phamhuuhuyhoang/bench-pwr-rig/board/BOM/bom.xlsx

Sheet: Sheet1
PN | Qty | $ | Description |  | Des | Qty | $ | $
UCC25630-1DDBR (https://www.digikey.com/en/products/detail/texas-instruments/UCC25630-1DDBR/8106200) | 1 | 1.79 | hysteretic controller |  | C1 | 1 | 3.3 | 3.3 |  |  |  |  | Capacitor, | aluminum, | 47 | µF, | 450 | V, | ±20%, | 2.82 | ohm, | TH | B43501A5476M000 | TDK
IPAW60R180P7SXKSA1 (https://www.digikey.com/en/products/detail/infineon-technologies/IPAW60R180P7SXKSA1/6823347) | 2 | 1.55 | mosfet |  | C2 | 1 | 1.72 | 1.72 |  |  |  |  | Capacitor, | film, | 1.5uF, | 450V, | ±10%, | TH | ECQ-E2W155KH | Panasonic
 | 1 | 2.97 | Lresonant |  | C3, C4 | 2 | 0.98 | 1.96 |  |  |  |  | Capacitor, | film, | 1uF, | 275V, | ±20%, | TH | R46KN410000P0M | Kemet
 |  |  |  |  | C5 | 1 | 0.12 | 0.12 |  |  |  |  | Capacitor, | ceramic, | 220 | pF, | 50 | V, | ±10%, | X7R, | 603 | GRM188R71H221KA01D | MuRata
 |  |  |  |  | C6 | 1 | 0.83 | 0.83 |  |  |  |  | Capacitor, | film, | 0.47 | µF, | 630 | V, | ±10%, | TH | B32922C3474K | TDK
 |  |  |  |  | C7, C8 | 2 | 1.18 | 2.36 |  |  |  |  | Capacitor, | film, | 0.022 | µF, | 630 | V, | ±5%, | TH | ECWF6223JL | Panasonic
 |  |  |  |  | C9, C11 | 2 | 0.93 | 1.86 |  |  |  |  | Capacitor, | film, | 150 | pF, | 630 | V, | ±5%, | TH | PFR5151J630J11L4BULK | Kemet
 |  |  |  |  | C10 | 1 | 0.42 | 0.42 |  |  |  |  | Capacitor, | ceramic, | 0.015 | µF, | 25 | V, | ±5%, | C0G/NP0, | 603 | C0603C153J3GACTU | Kemet
 |  |  |  |  | C12 | 1 | 0.2 | 0.2 |  |  |  |  | Capacitor, | ceramic, | 2.2 | µF, | 35 | V, | ±10%, | X5R, | 603 | GRM188R6YA225KA12D | MuRata
 |  |  |  |  | C13 | 1 | 0.23 | 0.23 |  |  |  |  | Capacitor, | ceramic, | 3.9 | pF, | 50 | V, | ±6%, | C0G/NP0, | 603 | 06035A3R9CAT2A | AVX
 |  |  |  |  | C14, C15 | 2 | 0.34 | 0.68 |  |  |  |  | Capacitor, | ceramic, | 4.7 | µF, | 16 | V, | ±10%, | X5R, | 603 | GRM188R61C475KAAJ | MuRata
 |  |  |  |  | C16 | 1 | 0.69 | 0.69 |  |  |  |  | Capacitor, | aluminum, | 120 | µF, | 63 | V, | ± | 20%, | 0.194 | ohm, | AEC-Q200 | Grade | 2, | TH | EEU-FC1J121 | Panasonic
 |  |  |  |  | C17 | 1 | 0.31 | 0.31 |  |  |  |  | Capacitor, | ceramic, | 0.15 | µF, | 16 | V, | ±20%, | Y5V, | 603 | C0603C154Z4VACTU | Kemet
 |  |  |  |  | C18 | 1 | 0.36 | 0.36 |  |  |  |  | Capacitor, | ceramic, | 2.2 | µF, | 16 | V, | ±10%, | X7R, | 1206 | C1206C225K4RACTU | Kemet
 |  |  |  |  | C19 | 0 | 0.1 | 0 |  |  |  |  | Capacitor, | ceramic, | 10 | pF, | 50 | V, | ±5%, | C0G/NP0, | 603 | 06035A100JAT2A | AVX
 |  |  |  |  | C20, C21, C22, C23 | 4 | 0.54 | 2.16 |  |  |  |  | Capacitor, | aluminum, | 470 | µF, | 35 | V, | ±20%, | TH | 35ZL470MEFC10X20 | Rubycon
 |  |  |  |  | C24, C25, C26, C27 | 4 |  | 0 |  |  |  |  | Capacitor, | ceramic, | 22 | µF, | 35 | V, | ± | 20%, | X5R, | 805 | C2012X5R1V226M15AC | TDK
 |  |  |  |  | C28 | 1 | 0.12 | 0.12 |  |  |  |  | Capacitor, | ceramic, | 0.047 | µF, | 16 | V, | ±10%, | X7R, | 603 | GRM188R71C473KA01DMuRata
 |  |  |  |  | C29 | 0 |  | 0 |  |  |  |  | Capacitor, | ceramic, | 10 | pF, | 50 | V, | ±5%, | C0G/NP0, | 603 | 06035A100JAT2A | AVX
 |  |  |  |  | C30 | 0 |  | 0 |  |  |  |  | Capacitor, | ceramic, | 3300 | pF, | 50 | V, | ±5%, | C0G/NP0, | 603 | GRM1885C1H332JA01D | MuRata
 |  |  |  |  | D1, D2 | 2 | 0.42 | 0.84 |  |  |  |  | Diode, | Ultrafast, | 600 | V, | 1 | A, | SMA | MURA160T3G | ON | Semiconductor
 |  |  |  |  | D3 | 1 | 0.91 | 0.91 |  |  |  |  | Diode, | Switching-Bridge, | 420 | V, | 8 | A, | TH | GBU8J-BP | Micro | Commercial | Components
 |  |  |  |  | D4 | 1 | 1.02 | 1.02 |  |  |  |  | Diode, | Schottky, | 60 | V, | 1 | A, | AEC-Q101, | SMB | STPS160UY | STMicroelectronics
 |  |  |  |  | D5 | 1 | 0.35 | 0.35 |  |  |  |  | Diode, | Ultrafast, | 600 | V, | 1 | A, | AEC-Q101, | SMAF | ES1JAF | Fairchild | Semiconductor
 |  |  |  |  | D6, D7 | 2 |  | 0 |  |  |  |  | Diode, | Schottky, | 100 | V, | 20 | A, | AEC-Q101, | TH | STPS41H100CTY | STMicroelectronics
 |  |  |  | Q6,Q7 |  | 2 | 1.62 | 3.24 | IPP086N10N3GXKSA1 (https://www.digikey.com/en/products/detail/infineon-technologies/IPP086N10N3GXKSA1/2081155)
 |  |  |  |  | D8, D9 | 2 | 0.16 | 0.32 |  |  |  |  | Diode, | Ultrafast, | 100 | V, | 0.15 | A, | SOD-123 | 1N4148W-7-F | Diodes | Inc.
 |  |  |  |  | D10 | 1 | 0.2 | 0.2 |  |  |  |  | Diode, | Zener, | 6.2 | V, | 500 | mW, | SOD-123 | MMSZ5234B-7-F | Diodes | Inc.
 |  |  |  |  | H1, H3, H5, H7 | 4 |  | 0 |  |  |  |  | Hex | standoff | 1-1/2" | L | #6-32 | nylon | 4824 | Keystone
 |  |  |  |  | H2, H4, H6, H8 | 4 |  | 0 |  |  |  |  | Hex | standoff | 0.5"L | #6-32 | nylon | 1903C | Keystone
 |  |  |  |  | H9, H11 | 2 |  | 0 |  |  |  |  | TO-220 | mounting | kit | 4880SG | Aavid | Thermalloy
 |  |  |  |  | H10, H12 | 2 |  | 0 |  |  |  |  | TO-247 | mounting | kit | 4880SG | Aavid | Thermalloy
 |  |  |  |  | H13, H14 | 2 |  | 0 |  |  |  |  | Large | thermal | pad | to | substitute | for | the | smaller | one | in | the | TO-247 | Mounting | Kit | SP900S-0.009-00-104 | Bergquist
 |  |  |  |  | HS1, HS2, HS3, HS4 | 4 |  | 0 |  |  |  |  | Heatsink | TO-220 | w/pins | 1.5" | tall | 531102B02500G | Aavid
 |  |  |  |  | J1 | 1 |  | 0 |  |  |  |  | Terminal | block, | 5.08 | mm, | 3x1, | brass, | TH | ED120/3DS | On-Shore | Technology
 |  |  |  | Uxx |  | 1 | 1.95 | 1.95 | UCC24624
 |  |  |  |  | U1 | 1 | 1.79 | 1.79 | UCC25630-1DDBR (https://www.digikey.com/en/products/detail/texas-instruments/UCC25630-1DDBR/8106200) |  |  | Enhanced | LLC | Resonant | Controller | with | Driver, | DDB0014A | UCC256301DDB | Texas | Instruments
 |  |  |  |  | U2, U3 | 2 | 0.58 | 1.16 |  |  |  | Optocoupler, | 5.3 | kV, | 50-600% | CTR, | TH | VO618A-3 | Vishay-Semiconductor
 |  |  |  |  | U4 | 1 | 0.24 | 0.24 |  |  |  | Low-Voltage | Adjustable | Precision | Shunt | Regulator, | 80mA, | -40 | to | 125 | degC, | 3-pin | SOT-89 | (PK), | Green | (RoHS | & | no | Sb/Br) | TLVH431AQPK | Texas | Instruments
 |  |  |  |  | Q1, Q2 | 2 | 2.25 | 4.5 | FCP190N65S3
 |  |  |  |  | J2, J3 | 2 |  | 0 |  | Terminal | block, | 5.08 | mm, | 2x1, | brass, | TH | ED120/2DS | On-Shore | Technology
 |  |  |  |  | J4 | 1 |  | 0 |  | Header, | 100.00 | mil, | 2 | x | 1, | tin, | TH | PEC02SAAN | Sullins | Connector | Solutions
 |  |  |  |  | J5 | 1 |  | 0 |  | Terminal | block, | 5.08 | mm, | 4x1, | brass, | TH | ED120/4DS | On-Shore | Technology
 |  |  |  |  | L1 | 1 | 3 | 3 |  | Inductor, | 50.00 | µH, | 0.023 | Ω, | TH | RLTI-1234 | Renco | Electronics
 |  |  |  |  | R1, R2, R3 | 3 | 0.1 | 0.3 |  | Resistor, | 4.99 | MΩ, | 1%, | 0.25 | W, | 1206 | CRCW12064M99FKEA | Vishay-Dale
 |  |  |  |  | R4 | 1 | 0.1 | 0.1 |  | Resistor, | 140.00 | kΩ, | 1%, | 0.1 | W, | 603 | CRCW0603140KFKEA | Vishay-Dale
 |  |  |  |  | R5, R6 | 2 | 0.1 | 0.2 |  | Resistor, | 10 | Ω, | 1%, | 0.125 | W, | 805 | CRCW080510R0FKEA | Vishay-Dale
 |  |  |  |  | R7, R8 | 2 | 0.1 | 0.2 |  | Resistor, | 5.11 | kΩ, | 1%, | 0.1W, | 603 | CRCW06035K11FKEA | Vishay-Dale
 |  |  |  |  | R9, R10, R11 | 3 | 0.1 | 0.3 |  | Resistor, | 1.65 | kΩ, | 1%, | 0.25 | W, | 1206 | CRCW12061K65FKEA | Vishay-Dale
 |  |  |  |  | R12, R27, R28, R29 | 4 | 0.1 | 0.4 |  | Resistor, | 10 | MΩ, | 1%, | 0.25 | W, | 1206 | CRCW120610M0FKEA | Vishay-Dale
 |  |  |  |  | R13 | 1 | 0.1 | 0.1 |  | Resistor, | 357.00 | Ω, | 1%, | 0.25 | W, | 1206 | CRCW1206357RFKEA | Vishay-Dale
 |  |  |  |  | R14 | 1 | 0.1 | 0.1 |  | Resistor, | 732.00 | kΩ, | 1%, | 0.1 | W, | 603 | CRCW0603732KFKEA | Vishay-Dale
 |  |  |  |  | R15 | 1 | 0.1 | 0.1 |  | Resistor, | 402.00 | kΩ, | 1%, | 0.1 | W, | 603 | CRCW0603402KFKEA | Vishay-Dale
 |  |  |  |  | R16 | 1 | 0.1 | 0.1 |  | Resistor, | 2.20 | Ω, | 5%, | 0.1 | W, | 603 | CRCW06032R20JNEA | Vishay-Dale
 |  |  |  |  | R17 | 1 | 0.1 | 0.1 |  | Resistor, | 42.20 | kΩ, | 1%, | 0.1 | W, | 603 | CRCW060342K2FKEA | Vishay-Dale
 |  |  |  |  | R18, R21, R22 | 3 | 0.1 | 0.3 |  | Resistor, | 10 | kΩ, | 1%, | 0.1 | W, | 603 | CRCW060310K0FKEA | Vishay-Dale
 |  |  |  |  | R19 | 1 | 0.1 | 0.1 |  | Resistor, | 2.00 | kΩ, | 1%, | 0.1 | W, | 603 | CRCW06032K00FKEA | Vishay-Dale
 |  |  |  |  | R20, R23 | 2 | 0.1 | 0.2 |  | Resistor, | 6.04 | kΩ, | 1%, | 0.1 | W, | 603 | CRCW06036K04FKEA | Vishay-Dale
 |  |  |  |  | R24, R32 | 2 | 0.1 | 0.2 |  | Resistor, | 0 | Ω, | 5%, | 0.1 | W, | 603 | CRCW06030000Z0EA | Vishay-Dale
 |  |  |  |  | R25 | 1 | 0.1 | 0.1 |  | Resistor, | 147.00 | kΩ, | 1%, | 0.1 | W, | 603 | CRCW0603147KFKEA | Vishay-Dale
 |  |  |  |  | R26 | 1 | 0.1 | 0.1 |  | Resistor, | 16.90 | kΩ, | 1%, | 0.1 | W, | 603 | CRCW060316K9FKEA | Vishay-Dale
 |  |  |  |  | R30, R31 | 2 | 0.1 | 0.2 |  | Resistor, | 1 | Ω, | 1%, | 0.125 | W, | 805 | CRCW08051R00FKEA | Vishay-Dale
 |  |  |  |  | RV1 | 1 | 0.55 | 0.55 |  | Varistor | 558.00 | V | 4.5KA, | TH | MOV-14D621K | Bourns
 |  |  |  |  | T1 | 1 |  | 0 |  | Transformer, | 840.00 | µH, | TH | RLTI-1233 | Renco | Electronics
 |  |  |  |  |  |  |  | 40.59

Sheet: Magnetic
 | Qty | $
PQ26/20-3C95 | 1 | 2.83
CLM/P-PQ26/20 | 1 | 1.35
CPV-PQ26/20-1S-12PD-Z | 1 | 0.97
 |  | 5.15
