phamhuuhuyhoang/bench-pwr-rig/board/bench_pwr_rig/bench_pwr_rig.kicad_pcb

## KiCad design board/bench_pwr_rig/bench_pwr_rig.kicad_pcb (2020-11-18)

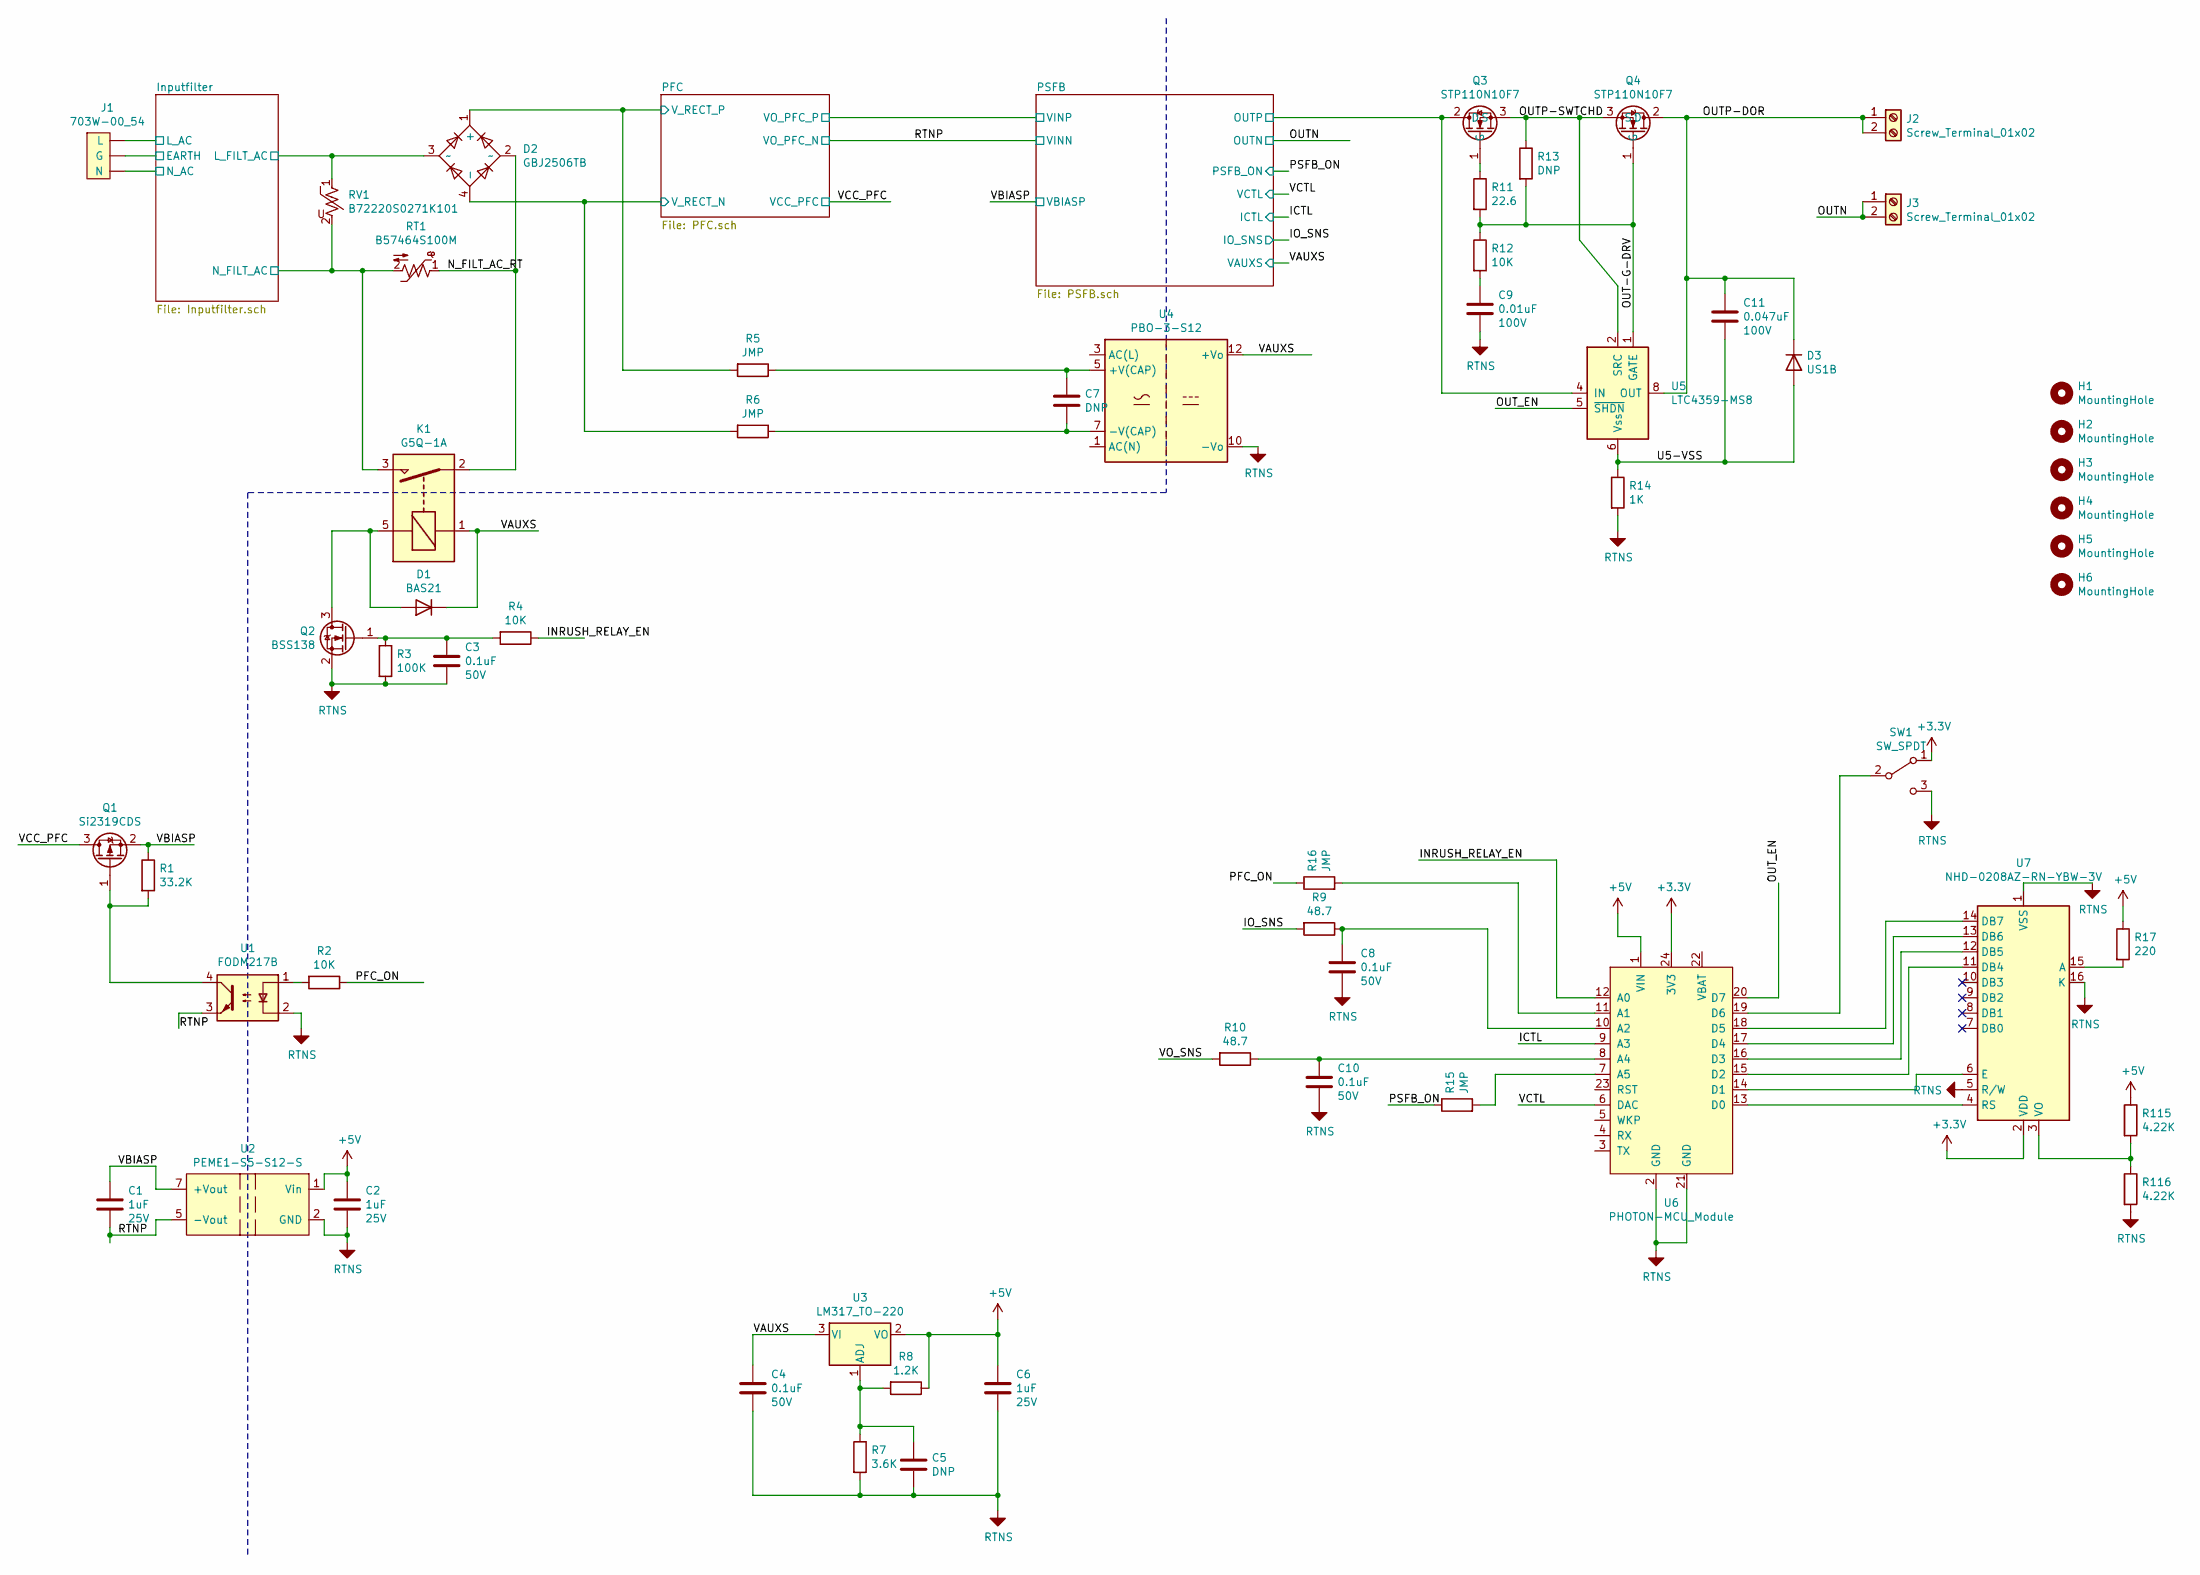
[picture p1: schematic bench_pwr_rig.sch, Bench Power Rig]

Parts:
C1, C2, C6: C1608X7R1E105K080AB; C_0603_1608Metric_Pad1.05x0.95mm_HandSolder; Voltage 25V
C3, C4, C8, C10: C1608X7R1H104K; C_0603_1608Metric_Pad1.05x0.95mm_HandSolder; Voltage 50V
C5: DNP; C_0603_1608Metric_Pad1.05x0.95mm_HandSolder
C7: DNP; C_1206_3216Metric
C9: CL21B103KCANNNC; C_0805_2012Metric_Pad1.15x1.40mm_HandSolder; Voltage 100V
C11: CL21B473KCFNNNE; C_0805_2012Metric_Pad1.15x1.40mm_HandSolder; Voltage 100V
D1: BAS21; SOT-23
D2: GBJ2506TB; Diode_Bridge_30.0x4.6x20.0mm_P10.0mm_P7.5mm
D3: US1B; D_SMA
H1, H2, H3, H4, H5, H6: MountingHole; MountingHole_4.3mm_M4
J1: 703W-00_54; 703W-00
J2, J3: Screw_Terminal_01x02; TerminalBlock_Phoenix_MKDS-1,5-2-5.08_1x02_P5.08mm_Horizont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
K1: G5Q-1A; Relay_SPST_Omron-G5Q-1A
Q1: Si2319CDS; SOT-23
Q2: BSS138; SOT-23
Q3, Q4: STP110N10F7; TO-220-3_Vertical
R1: CRCW060333K2FKEA; R_0603_1608Metric_Pad1.05x0.95mm_HandSolder
R2, R4, R12: CRCW060310K0FKEA; R_0603_1608Metric_Pad1.05x0.95mm_HandSolder
R3: 0603WAF1003T5E; R_0603_1608Metric_Pad1.05x0.95mm_HandSolder
R5, R6, R15, R16: JMP; R_0603_1608Metric_Pad1.05x0.95mm_HandSolder
R7: 0603WAF3601T5E; R_0603_1608Metric_Pad1.05x0.95mm_HandSolder
R8: 0603WAF1201T5E; R_0603_1608Metric_Pad1.05x0.95mm_HandSolder
R9, R10: 0603WAF4872T5E; R_0603_1608Metric_Pad1.05x0.95mm_HandSolder
R11: 0603WAF226JT5E; R_0603_1608Metric_Pad1.05x0.95mm_HandSolder
R13: DNP; R_0603_1608Metric_Pad1.05x0.95mm_HandSolder
R14: 0805W8F1001T5E; R_0805_2012Metric_Pad1.15x1.40mm_HandSolder
R17: 0603WAF2200T5E; R_0603_1608Metric_Pad1.05x0.95mm_HandSolder
R115, R116: 0603WAF4221T5E; R_0603_1608Metric_Pad1.05x0.95mm_HandSolder
RT1: B57464S100M; C_Disc_D16.0mm_W5.0mm_P7.50mm
RV1: B72220S0271K101; C_Disc_D16.0mm_W5.0mm_P10.00mm
SW1: SW_SPDT; SW_SPDT_CK-JS102011SAQN
U1: FODM217B; SOP-4_4.4x2.6mm_P1.27mm
U2: PEME1-S5-S12-S; Converter_DCDC_Murata_MGJ2DxxxxxxSC_THT
U3: LM317_TO-220; TO-220-3_Vertical
U4: PBO-3-S12; Converter_ACDC_CUI_PBO-3-Sxx_THT_Vertical
U5: LTC4359-MS8; MSOP-8_3x3mm_P0.65mm
U6: PHOTON-MCU_Module; photon_tht
U7: NHD-0208AZ-RN-YBW-3V; PinHeader_2x08_P2.54mm_Vertical

Connections:
+3V3: SW1.1 (A), U6.24 (3V3), U7.2 (VDD)
+5V: C2.1, C6.1, R8.1, R17.1, R115.1, U2.1 (Vin), U3.2 (VO), U6.1 (VIN); also elsewhere on the board
+12V: C4.1, D1.3 (K), K1.1, U3.3 (VI), U4.12 (+Vo); also elsewhere on the board
/ICTL: U6.9 (A3); also elsewhere on the board
/INRUSH_RELAY_EN: R4.1, U6.12 (A0)
/IO_SNS: R9.2; also elsewhere on the board
/Inputfilter/L_AC: J1.1 (L); also elsewhere on the board
/Inputfilter/L_FILT_AC: D2.3 (~~), RV1.1; also elsewhere on the board
/Inputfilter/N_AC: J1.3 (N); also elsewhere on the board
/Inputfilter/N_FILT_AC: K1.3, RT1.2, RV1.2; also elsewhere on the board
/N_FILT_AC_RT: D2.2 (~~), K1.2, RT1.1
/OUT-G-DRV: Q4.1 (G), R11.2, R12.1, R13.2, U5.1 (GATE)
/OUTN: J3.1, J3.2; also elsewhere on the board
/OUTP-DOR: C11.1, D3.1 (K), J2.1, J2.2, Q4.2 (D), U5.8 (OUT)
/OUTP-SWTCHD: Q3.3 (S), Q4.3 (S), R13.1, U5.2 (SRC)
/OUT_EN: U5.5 (~SHDN), U6.20 (D7)
/PFC/V_RECT_N: D2.4 (-), R6.2; also elsewhere on the board
/PFC/V_RECT_P: D2.1 (+), R5.2; also elsewhere on the board
/PFC_ON: R2.1, R16.1
/PSFB/OUTP: Q3.2 (D), U5.4 (IN); also elsewhere on the board
/PSFB_ON: R15.1; also elsewhere on the board
/RTNP: C1.2, U1.3, U2.5 (-Vout); also elsewhere on the board
/U5-VSS: C11.2, D3.2 (A), R14.1, U5.6 (Vss)
/VBIASP: C1.1, Q1.2 (S), R1.1, U2.7 (+Vout); also elsewhere on the board
/VCC_PFC: Q1.3 (D); also elsewhere on the board
/VCTL: U6.6 (DAC); also elsewhere on the board
/VO_SNS: R10.2
Earth: J1.2 (G); also elsewhere on the board
GND: C2.2, C3.2, C4.2, C5.2, C6.2, C8.2, C9.2, C10.2, Q2.2 (S), R3.2, R7.2, R14.2, R116.2, SW1.3 (C), U1.2, U2.2 (GND), U4.10 (-Vo), U6.2 (GND), U6.21 (GND), U7.1 (VSS), U7.5 (R/W), U7.16 (K); also elsewhere on the board
unnamed: C3.1, Q2.1 (G), R3.1, R4.2
unnamed: C5.1, R7.1, R8.2, U3.1 (ADJ)
unnamed: C7.1, R5.1, U4.5 (+V(CAP))
unnamed: C7.2, R6.1, U4.7 (-V(CAP))
unnamed: C8.1, R9.1, U6.10 (A2)
unnamed: C9.1, R12.2
unnamed: C10.1, R10.1, U6.8 (A4)
unnamed: D1.1 (A), K1.5, Q2.3 (D)
unnamed: Q1.1 (G), R1.2, U1.4
unnamed: Q3.1 (G), R11.1
unnamed: R2.2, U1.1
unnamed: R15.2, U6.7 (A5)
unnamed: R16.2, U6.11 (A1)
unnamed: R17.2, U7.15 (A)
unnamed: R115.2, R116.1, U7.3 (VO)
unnamed: SW1.2 (B), U6.19 (D6)
unnamed: U6.13 (D0), U7.4 (RS)
unnamed: U6.14 (D1), U7.6 (E)
unnamed: U6.15 (D2), U7.11 (DB4)
unnamed: U6.16 (D3), U7.12 (DB5)
unnamed: U6.17 (D4), U7.13 (DB6)
unnamed: U6.18 (D5), U7.14 (DB7)

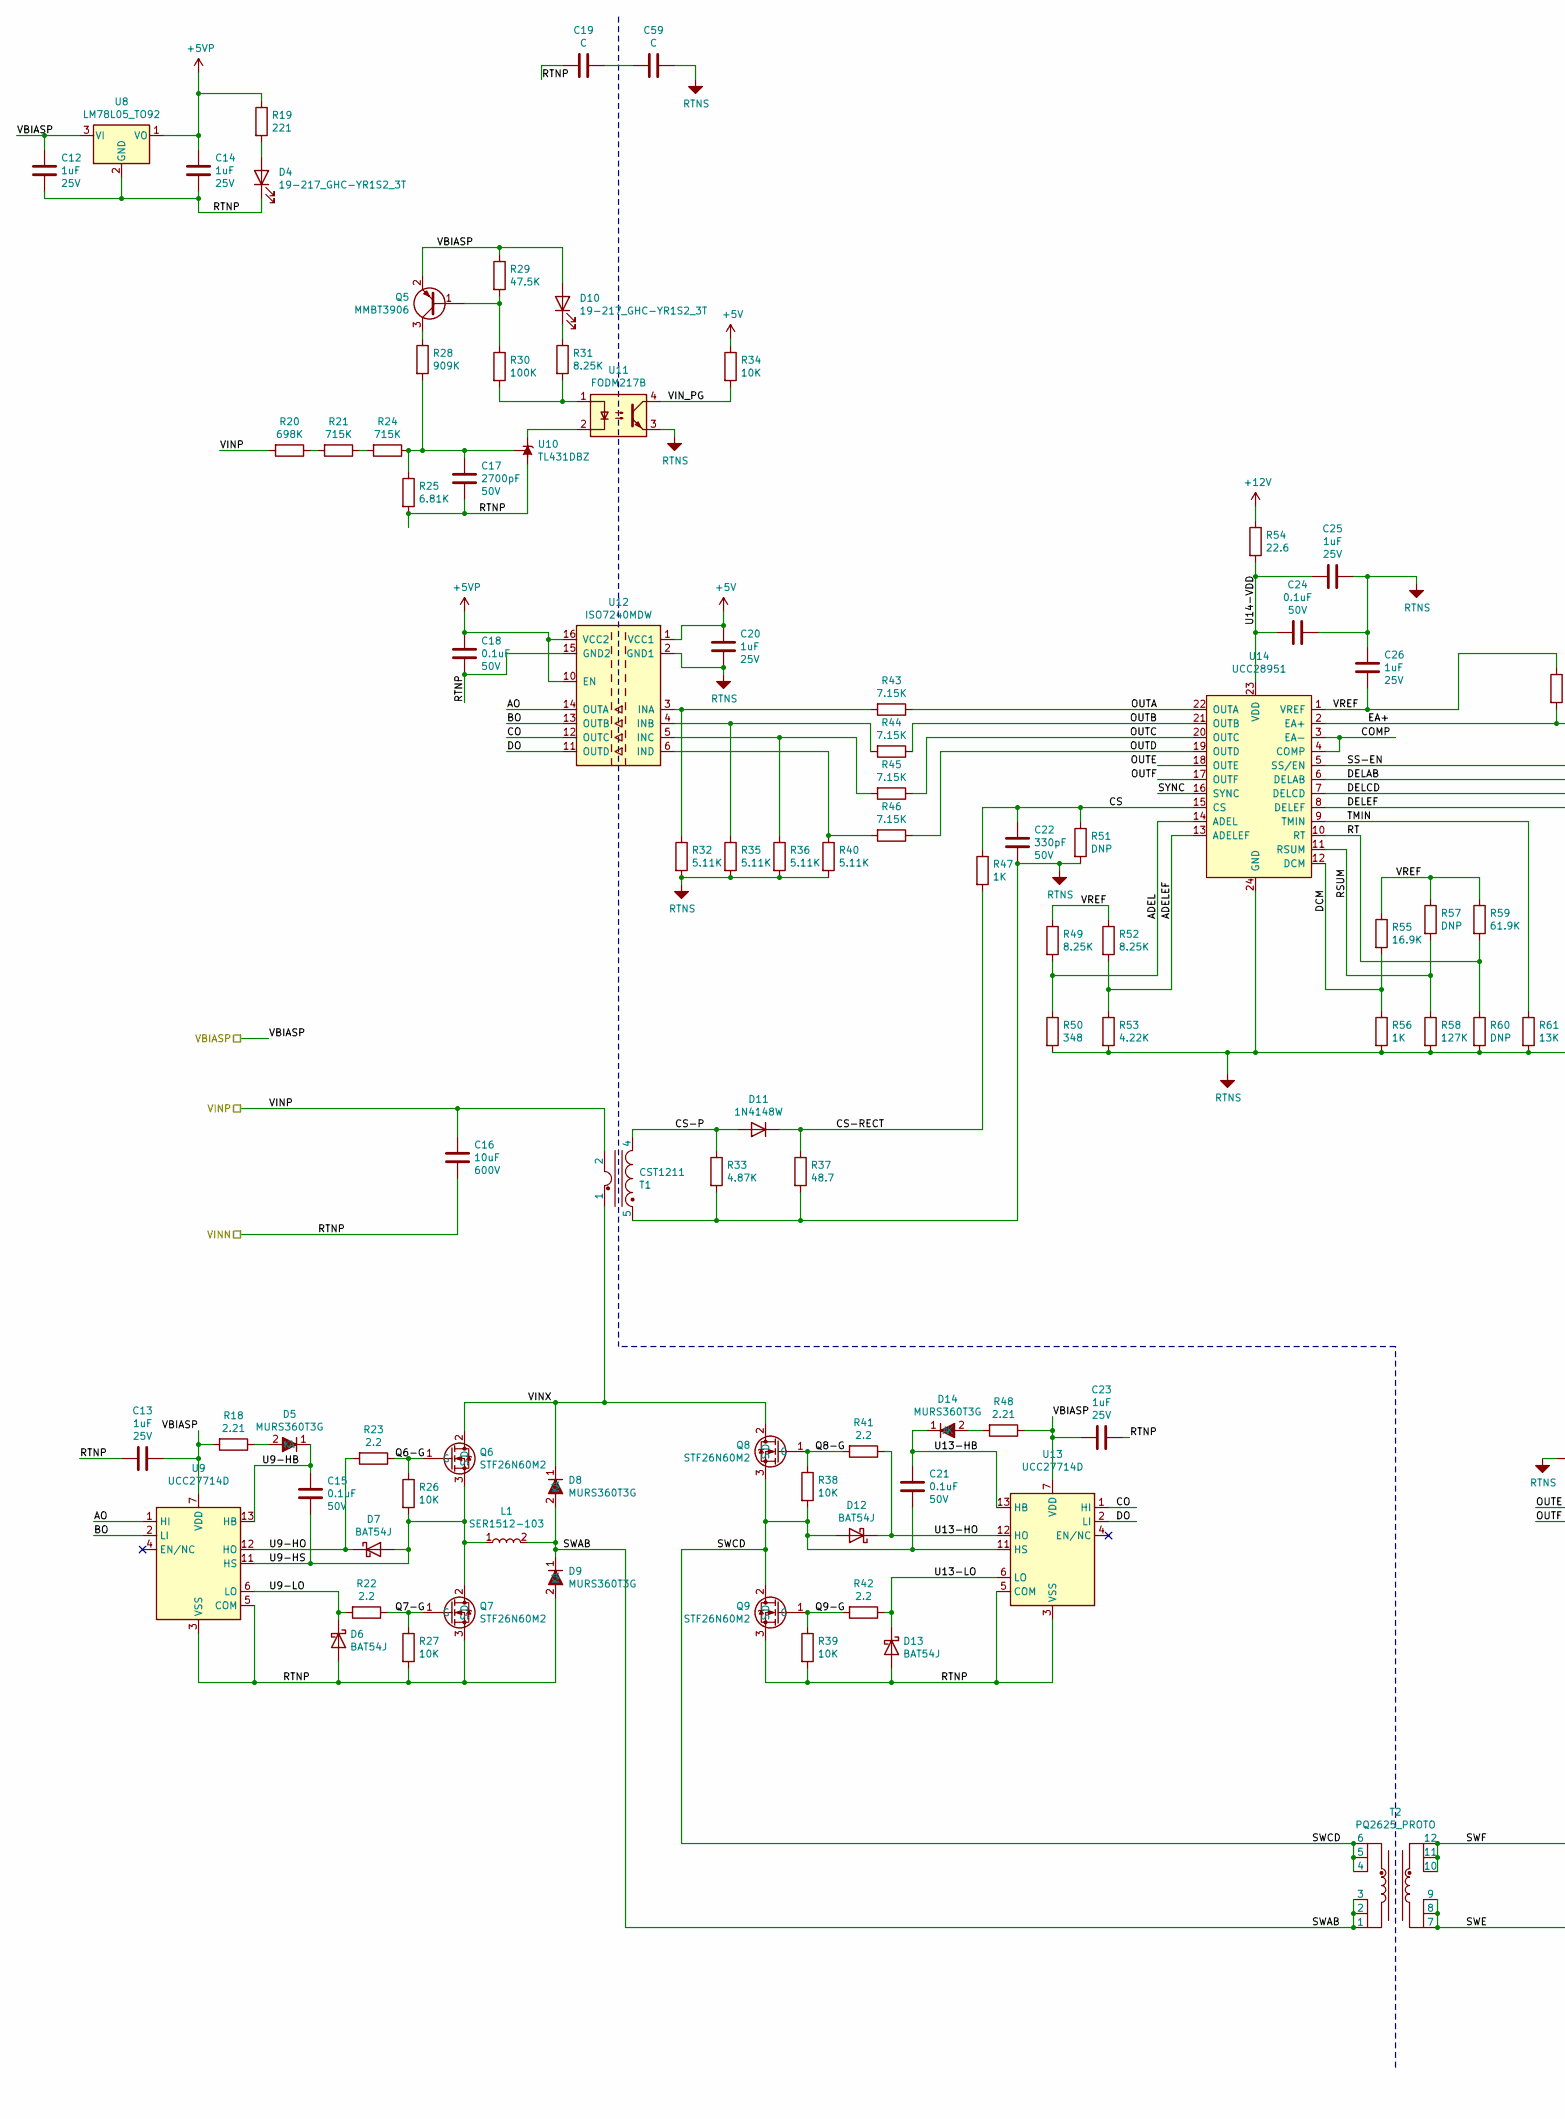
[picture p2: schematic PSFB.sch, PSFB powertrain, part in row 1, column 1]

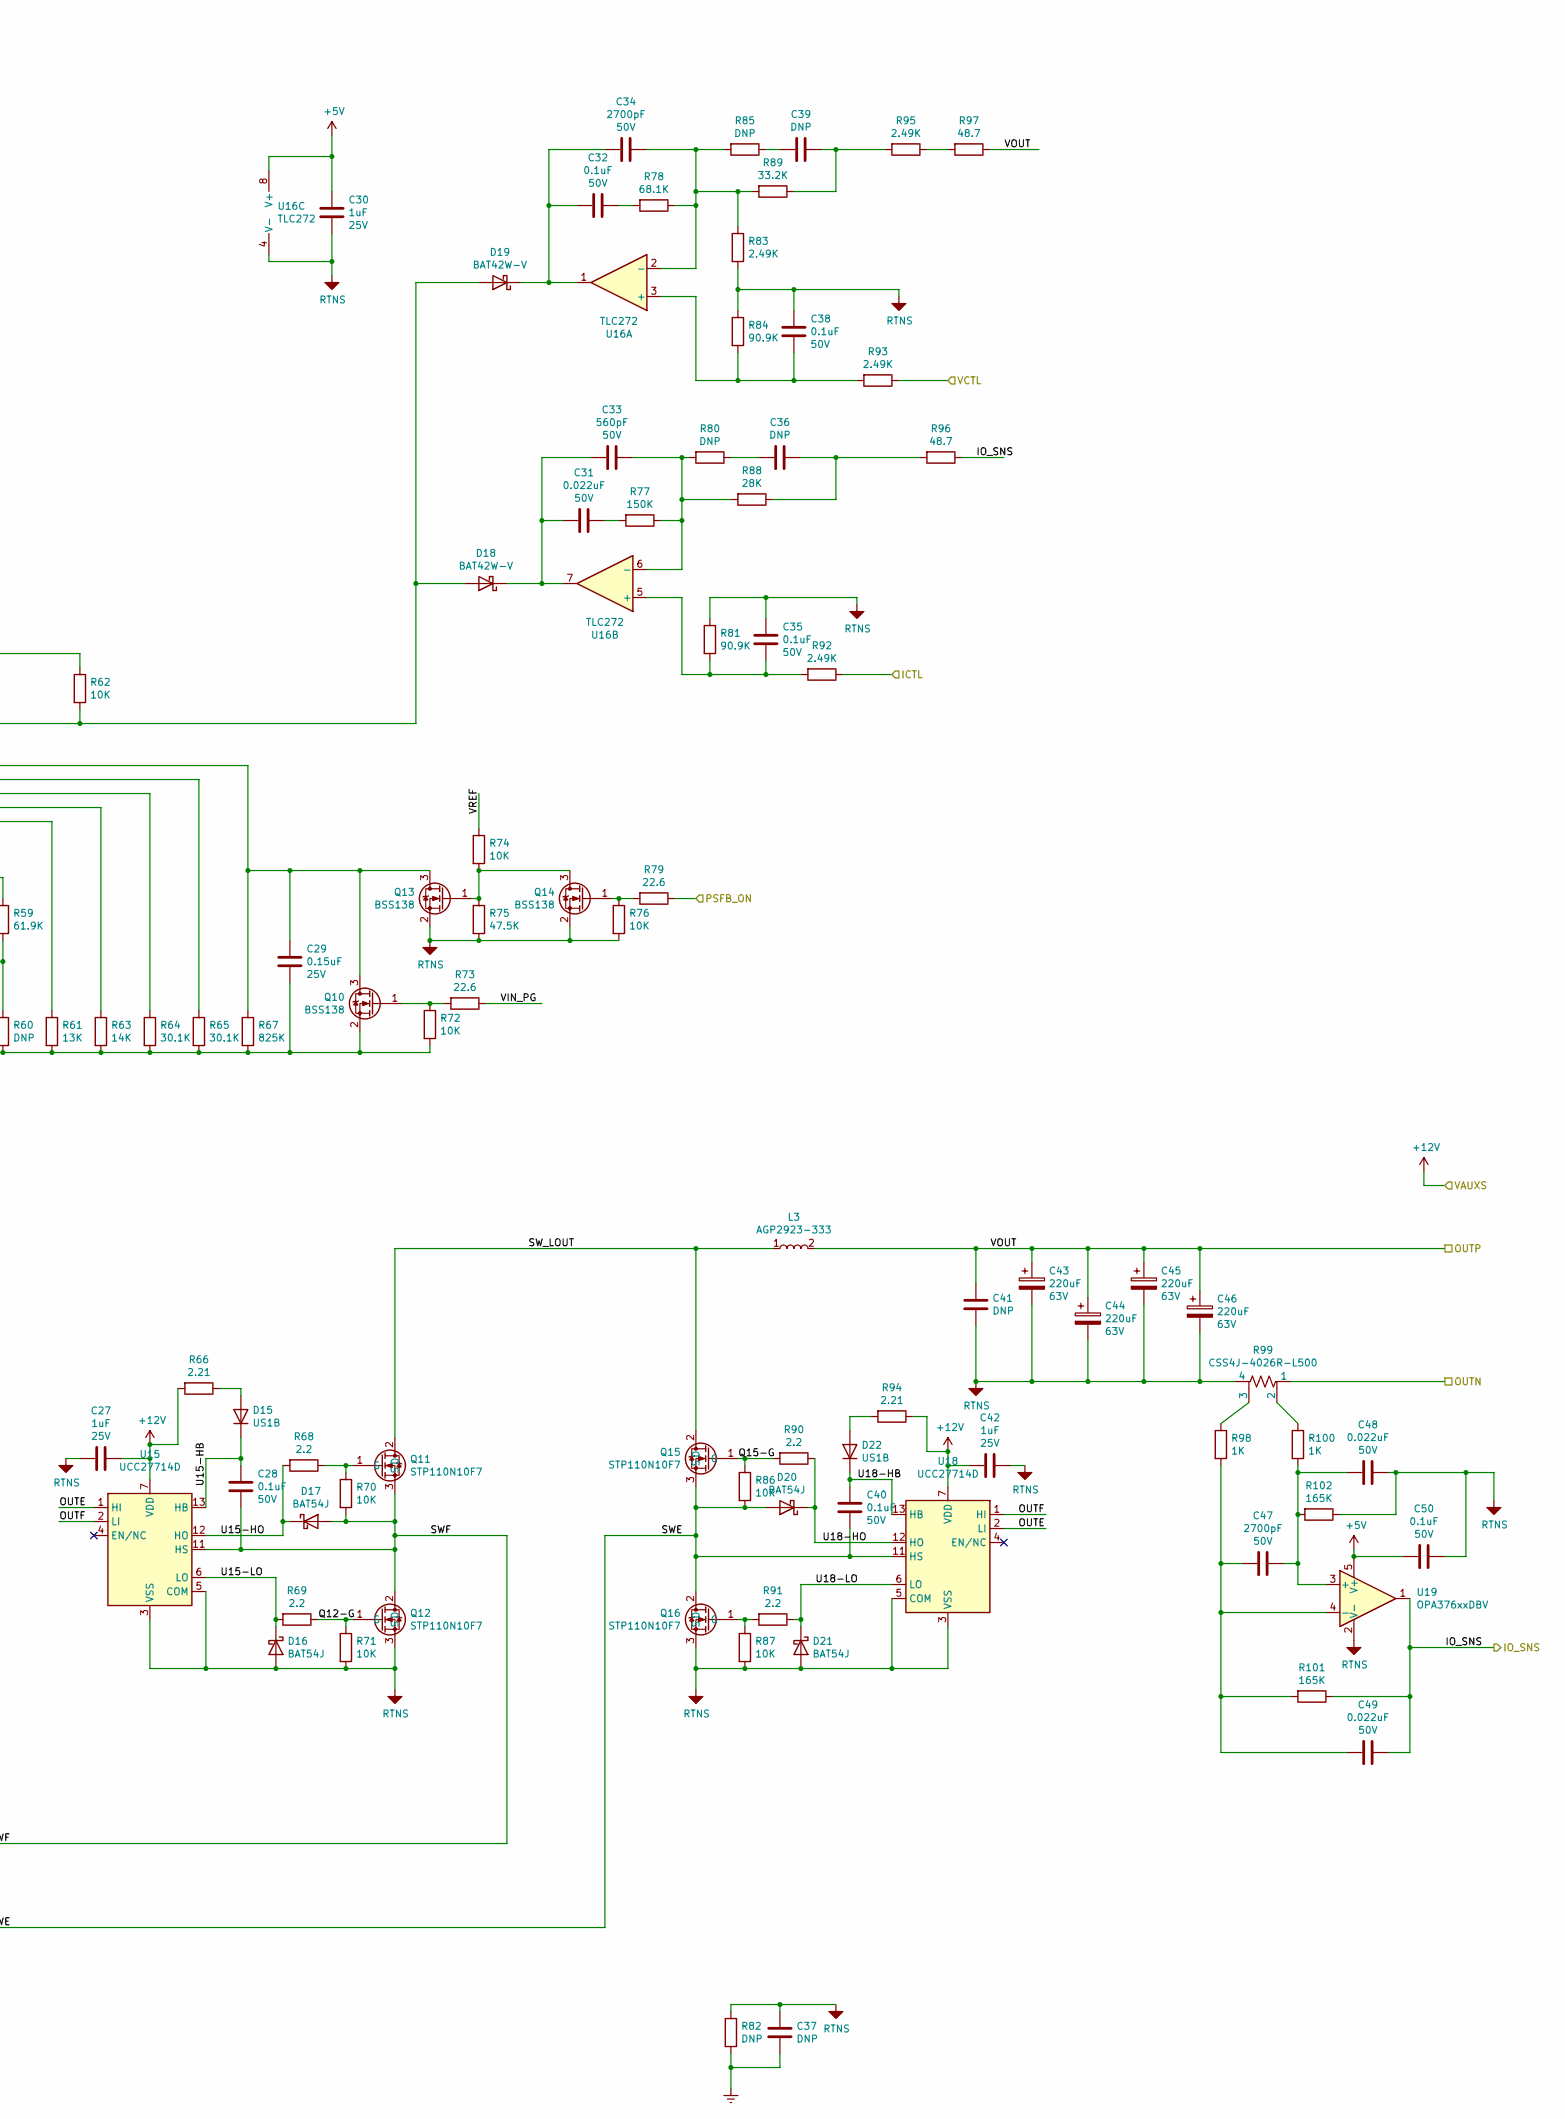
[picture p3: schematic PSFB.sch, PSFB powertrain, part in row 1, column 2]

Parts:
C12, C13, C14, C20, C23, C25, C26, C27, C30, C42: C1608X7R1E105K080AB; C_0603_1608Metric_Pad1.05x0.95mm_HandSolder; Voltage 25V
C15, C18, C21, C24, C28, C32, C35, C38, C40, C50: C1608X7R1H104K; C_0603_1608Metric_Pad1.05x0.95mm_HandSolder; Voltage 50V
C16: C4AEHBU5100A11J; C_Rect_L33.0mm_W20.0mm_P27.50mm_MKS4; Voltage 600V
C17, C34, C47: C1608C0G1H272J; C_0603_1608Metric_Pad1.05x0.95mm_HandSolder; Voltage 50V
C19, C59: C; C_Disc_D9.0mm_W5.0mm_P10.00mm
C22: CL10C331JB8NNNC; C_0603_1608Metric_Pad1.05x0.95mm_HandSolder; Voltage 50V
C29: CL10B154KA8NNNC; C_0603_1608Metric_Pad1.05x0.95mm_HandSolder; Voltage 25V
C31, C48, C49: CL10B223KB8NNNC; C_0603_1608Metric_Pad1.05x0.95mm_HandSolder; Voltage 50V
C33: C1608C0G1H561J; C_0603_1608Metric_Pad1.05x0.95mm_HandSolder; Voltage 50V
C36, C39: DNP; C_0603_1608Metric_Pad1.05x0.95mm_HandSolder
C37, C41: DNP; C_1206_3216Metric
C43, C44, C45, C46: EEU-EB1J221; CP_Radial_D10.0mm_P5.00mm; Voltage 63V
D4, D10: 19-217_GHC-YR1S2_3T; LED_0603_1608Metric_Pad1.05x0.95mm_HandSolder
D5, D8, D9, D14: MURS360T3G; D_SMC_Handsoldering
D6, D7, D12, D13, D16, D17, D20, D21: BAT54J; D_SOD-323F
D11: 1N4148W; D_SOD-123
D15, D22: US1B; D_SMA
D18, D19: BAT42W-V; D_SOD-123
L1: SER1512-103; L_Coilcraft_SER1512
L3: AGP2923-333; L_Coilcraft_AGP2923
Q5: MMBT3906; SOT-23
Q6, Q7, Q8, Q9: STF26N60M2; TO-220-3_Vertical_Stag
Q10, Q13, Q14: BSS138; SOT-23
Q11, Q12, Q15, Q16: STP110N10F7; TO-220-3_Vertical
R18, R48, R66, R94: CRCW08052R21FKEA; R_0805_2012Metric_Pad1.15x1.40mm_HandSolder
R19: CRCW0603221RFKEA; R_0603_1608Metric_Pad1.05x0.95mm_HandSolder
R20: 1206W4F6983T5E; R_1206_3216Metric_Pad1.42x1.75mm_HandSolder
R21, R24: 1206W4F7153T5E; R_1206_3216Metric_Pad1.42x1.75mm_HandSolder
R22, R23, R41, R42, R68, R69, R90, R91: 0603WAF220KT5E; R_0603_1608Metric_Pad1.05x0.95mm_HandSolder
R25: 0603WAF6811T5E; R_0603_1608Metric_Pad1.05x0.95mm_HandSolder
R26, R27, R34, R38, R39, R62, R70, R71, R72, R74, R76, R86, R87: CRCW060310K0FKEA; R_0603_1608Metric_Pad1.05x0.95mm_HandSolder
R28: 0603WAF9093T5E; R_0603_1608Metric_Pad1.05x0.95mm_HandSolder
R29, R75: 0603WAF4752T5E; R_0603_1608Metric_Pad1.05x0.95mm_HandSolder
R30: 0603WAF1003T5E; R_0603_1608Metric_Pad1.05x0.95mm_HandSolder
R31, R49, R52: 0603WAF8251T5E; R_0603_1608Metric_Pad1.05x0.95mm_HandSolder
R32, R35, R36, R40: 0603WAF5111T5E; R_0603_1608Metric_Pad1.05x0.95mm_HandSolder
R33: 0603WAF4871T5E; R_0603_1608Metric_Pad1.05x0.95mm_HandSolder
R37, R96, R97: 0603WAF4872T5E; R_0603_1608Metric_Pad1.05x0.95mm_HandSolder
R43, R44, R45, R46: 0603WAF7151T5E; R_0603_1608Metric_Pad1.05x0.95mm_HandSolder
R47, R56, R98, R100: 0603WAF1001T5E; R_0603_1608Metric_Pad1.05x0.95mm_HandSolder
R50: 0603WAF3480T5E; R_0603_1608Metric_Pad1.05x0.95mm_HandSolder
R51, R57, R60, R80, R85: DNP; R_0603_1608Metric_Pad1.05x0.95mm_HandSolder
R53: 0603WAF4221T5E; R_0603_1608Metric_Pad1.05x0.95mm_HandSolder
R54, R73, R79: 0603WAF226JT5E; R_0603_1608Metric_Pad1.05x0.95mm_HandSolder
R55: 0603WAF1692T5E; R_0603_1608Metric_Pad1.05x0.95mm_HandSolder
R58: 0603WAF1273T5E; R_0603_1608Metric_Pad1.05x0.95mm_HandSolder
R59: 0603WAF6192T5E; R_0603_1608Metric_Pad1.05x0.95mm_HandSolder
R61: CRCW060313K0FKEA; R_0603_1608Metric_Pad1.05x0.95mm_HandSolder
R63: 0603WAF1402T5E; R_0603_1608Metric_Pad1.05x0.95mm_HandSolder
R64, R65: 0603WAF3012T5E; R_0603_1608Metric_Pad1.05x0.95mm_HandSolder
R67: 0603WAF8253T5E; R_0603_1608Metric_Pad1.05x0.95mm_HandSolder
R77: 0603WAF1503T5E; R_0603_1608Metric_Pad1.05x0.95mm_HandSolder
R78: 0603WAF6812T5E; R_0603_1608Metric_Pad1.05x0.95mm_HandSolder
R81, R84: 0603WAF9092T5E; R_0603_1608Metric_Pad1.05x0.95mm_HandSolder
R82: DNP; R_1206_3216Metric
R83, R92, R93, R95: 0603WAF2491T5E; R_0603_1608Metric_Pad1.05x0.95mm_HandSolder
R88: 0603WAF2802T5E; R_0603_1608Metric_Pad1.05x0.95mm_HandSolder
R89: CRCW060333K2FKEA; R_0603_1608Metric_Pad1.05x0.95mm_HandSolder
R99: CSS4J-4026R-L500; R_Shunt_Bourns_CSS4J_4026
R101, R102: 0603WAF1653T5E; R_0603_1608Metric_Pad1.05x0.95mm_HandSolder
T1: CST1211; Transformer_Coilcraft_CST1211
T2: PQ2625_PROTO; CPV-PQ26-25-1S-12PD-Z
U8: LM78L05_TO92; TO-92_Inline
U9, U13, U15, U18: UCC27714D; SOIC-14_3.9x8.7mm_P1.27mm
U10: TL431DBZ; SOT-23
U11: FODM217B; SOP-4_4.4x2.6mm_P1.27mm
U12: ISO7240MDW; SOIC-16W_7.5x10.3mm_P1.27mm
U14: UCC28951; TSSOP-24_4.4x7.8mm_P0.65mm
U16: TLC272; SOIC-8_3.9x4.9mm_P1.27mm
U19: OPA376xxDBV; SOT-23-5

Connections:
+5V: C20.1, C30.1, C50.2, R34.1, U12.1 (VCC1), U16.8 (V+), U19.5 (V+); also elsewhere on the board
+5VP: C14.1, C18.1, R19.1, U8.1 (VO), U12.10 (EN), U12.16 (VCC2)
+12V: C27.1, C42.2, R54.1, R66.2, R94.1, U15.7 (VDD), U18.7 (VDD); also elsewhere on the board
/ICTL: R92.1; also elsewhere on the board
/IO_SNS: C49.2, R96.1, R101.1, U19.1; also elsewhere on the board
/OUTN: R99.1; also elsewhere on the board
/PSFB/ADEL: R49.2, R50.1, U14.14 (ADEL)
/PSFB/ADELEF: R52.2, R53.1, U14.13 (ADELEF)
/PSFB/AO: U9.1 (HI), U12.14 (OUTA)
/PSFB/BO: U9.2 (LI), U12.13 (OUTB)
/PSFB/CO: U12.12 (OUTC), U13.1 (HI)
/PSFB/COMP: U14.3 (EA-), U14.4 (COMP)
/PSFB/CS: C22.1, R47.1, R51.1, U14.15 (CS)
/PSFB/CS-P: D11.2 (A), R33.1, T1.4
/PSFB/CS-RECT: D11.1 (K), R37.1, R47.2
/PSFB/DCM: R55.2, R56.1, U14.12 (DCM)
/PSFB/DELAB: R65.1, U14.6 (DELAB)
/PSFB/DELCD: R64.1, U14.7 (DELCD)
/PSFB/DELEF: R63.1, U14.8 (DELEF)
/PSFB/DO: U12.11 (OUTD), U13.2 (LI)
/PSFB/EA+: D18.2 (A), D19.2 (A), R62.2, U14.2 (EA+)
/PSFB/OUTA: R43.1, U14.22 (OUTA)
/PSFB/OUTB: R44.1, U14.21 (OUTB)
/PSFB/OUTC: R45.1, U14.20 (OUTC)
/PSFB/OUTD: R46.1, U14.19 (OUTD)
/PSFB/OUTE: U14.18 (OUTE), U15.1 (HI), U18.2 (LI)
/PSFB/OUTF: U14.17 (OUTF), U15.2 (LI), U18.1 (HI)
/PSFB/OUTP: C41.1, C43.1, C44.1, C45.1, C46.1, L3.2, R97.1; also elsewhere on the board
/PSFB/Q6-G: Q6.1 (G), R23.1, R26.1
/PSFB/Q7-G: Q7.1 (G), R22.1, R27.1
/PSFB/Q8-G: Q8.1 (G), R38.1, R41.2
/PSFB/Q9-G: Q9.1 (G), R39.1, R42.2
/PSFB/Q12-G: Q12.1 (G), R69.1, R71.1
/PSFB/Q15-G: Q15.1 (G), R86.1, R90.2
/PSFB/RSUM: R57.2, R58.1, U14.11 (RSUM)
/PSFB/RT: R59.2, R60.1, U14.10 (RT)
/PSFB/SS-EN: C29.1, Q10.3 (D), Q13.3 (D), R67.1, U14.5 (SS/EN)
/PSFB/SWAB: D8.2 (A), D9.1 (K), L1.2, T2.1, T2.2, T2.3
/PSFB/SWCD: C21.2, D12.2 (A), Q8.3 (S), Q9.2 (D), R38.2, T2.4, T2.5, T2.6, U13.11 (HS)
/PSFB/SWE: C40.2, D20.2 (A), Q15.3 (S), Q16.2 (D), R86.2, T2.7, T2.8, T2.9, U18.11 (HS)
/PSFB/SWF: C28.2, D17.2 (A), Q11.3 (S), Q12.2 (D), R70.2, T2.10, T2.11, T2.12, U15.11 (HS)
/PSFB/SW_LOUT: L3.1, Q11.2 (D), Q15.2 (D)
/PSFB/SYNC: U14.16 (SYNC)
/PSFB/TMIN: R61.1, U14.9 (TMIN)
/PSFB/U9-HB: C15.1, D5.1 (K), U9.13 (HB)
/PSFB/U9-HO: D7.1 (K), R23.2, U9.12 (HO)
/PSFB/U9-HS: C15.2, D7.2 (A), L1.1, Q6.3 (S), Q7.2 (D), R26.2, U9.11 (HS)
/PSFB/U9-LO: D6.1 (K), R22.2, U9.6 (LO)
/PSFB/U13-HB: C21.1, D14.1 (K), U13.13 (HB)
/PSFB/U13-HO: D12.1 (K), R41.1, U13.12 (HO)
/PSFB/U13-LO: D13.1 (K), R42.1, U13.6 (LO)
/PSFB/U14-VDD: C24.2, C25.2, R54.2, U14.23 (VDD)
/PSFB/U15-HB: C28.1, D15.1 (K), U15.13 (HB)
/PSFB/U15-HO: D17.1 (K), R68.2, U15.12 (HO)
/PSFB/U15-LO: D16.1 (K), R69.2, U15.6 (LO)
/PSFB/U18-HB: C40.1, D22.1 (K), U18.13 (HB)
/PSFB/U18-HO: D20.1 (K), R90.1, U18.12 (HO)
/PSFB/U18-LO: D21.1 (K), R91.1, U18.6 (LO)
/PSFB/VINP: C16.1, R20.2, T1.2; also elsewhere on the board
/PSFB/VINX: D8.1 (K), Q6.2 (D), Q8.2 (D), T1.1
/PSFB/VIN_PG: R34.2, R73.1, U11.4
/PSFB/VREF: C26.2, R49.1, R52.1, R55.1, R57.1, R59.1, R62.1, R74.1, U14.1 (VREF)
/PSFB_ON: R79.1; also elsewhere on the board
/RTNP: C12.2, C13.2, C14.2, C16.2, C17.2, C18.2, C19.2, C23.1, D4.1 (K), D6.2 (A), D9.2 (A), D13.2 (A), Q7.3 (S), Q9.3 (S), R25.2, R27.2, R39.2, U8.2 (GND), U9.3 (VSS), U9.5 (COM), U10.3 (A), U12.9 (GND2), U12.15 (GND2), U13.3 (VSS), U13.5 (COM); also elsewhere on the board
/VBIASP: C12.1, C13.1, C23.2, D10.2 (A), Q5.2 (E), R18.2, R29.1, R48.1, U8.3 (VI), U9.7 (VDD), U13.7 (VDD); also elsewhere on the board
/VCTL: R93.1; also elsewhere on the board
Earth: C37.2, R82.2; also elsewhere on the board
GND: C20.2, C22.2, C24.1, C25.1, C26.1, C27.2, C29.2, C30.2, C35.1, C37.1, C38.1, C41.2, C42.1, C43.2, C44.2, C45.2, C46.2, C48.1, C50.1, C59.1, D16.2 (A), D21.2 (A), Q10.2 (S), Q12.3 (S), Q13.2 (S), Q14.2 (S), Q16.3 (S), R32.2, R33.2, R35.2, R36.2, R37.2, R40.2, R50.2, R51.2, R53.2, R56.2, R58.2, R60.2, R61.2, R63.2, R64.2, R65.2, R67.2, R71.2, R72.2, R75.2, R76.2, R81.1, R82.1, R83.2, R84.1, R87.2, R99.4, R102.1, T1.5, U11.3, U12.2 (GND1), U12.8 (GND1), U14.24 (GND), U15.3 (VSS), U15.5 (COM), U16.4 (V-), U18.3 (VSS), U18.5 (COM), U19.2 (V-); also elsewhere on the board
unnamed: C17.1, R24.1, R25.1, R28.2, U10.2 (REF)
unnamed: C19.1, C59.2
unnamed: C31.1, R77.2
unnamed: C31.2, C33.2, D18.1 (K), U16.7
unnamed: C32.1, R78.2
unnamed: C32.2, C34.2, D19.1 (K), U16.1
unnamed: C33.1, R77.1, R80.2, R88.2, U16.6 (-)
unnamed: C34.1, R78.1, R83.1, R85.2, R89.2, U16.2 (-)
unnamed: C35.2, R81.2, R92.2, U16.5 (+)
unnamed: C36.1, R88.1, R96.2
unnamed: C36.2, R80.1
unnamed: C38.2, R84.2, R93.2, U16.3 (+)
unnamed: C39.1, R89.1, R95.2
unnamed: C39.2, R85.1
unnamed: C47.1, C48.2, R100.2, R102.2, U19.3 (+)
unnamed: C47.2, C49.1, R98.2, R101.2, U19.4 (-)
unnamed: D4.2 (A), R19.2
unnamed: D5.2 (A), R18.1
unnamed: D10.1 (K), R31.1
unnamed: D14.2 (A), R48.2
unnamed: D15.2 (A), R66.1
unnamed: D22.2 (A), R94.2
unnamed: Q5.1 (B), R29.2, R30.1
unnamed: Q5.3 (C), R28.1
unnamed: Q10.1 (G), R72.1, R73.2
unnamed: Q11.1 (G), R68.1, R70.1
unnamed: Q13.1 (G), Q14.3 (D), R74.2, R75.1
unnamed: Q14.1 (G), R76.1, R79.2
unnamed: Q16.1 (G), R87.1, R91.2
unnamed: R20.1, R21.2
unnamed: R21.1, R24.2
unnamed: R30.2, R31.2, U11.1
unnamed: R32.1, R43.2, U12.3 (INA)
unnamed: R35.1, R44.2, U12.4 (INB)
unnamed: R36.1, R45.2, U12.5 (INC)
unnamed: R40.1, R46.2, U12.6 (IND)
unnamed: R95.1, R97.2
unnamed: R98.1, R99.3
unnamed: R99.2, R100.1
unnamed: U10.1 (K), U11.2

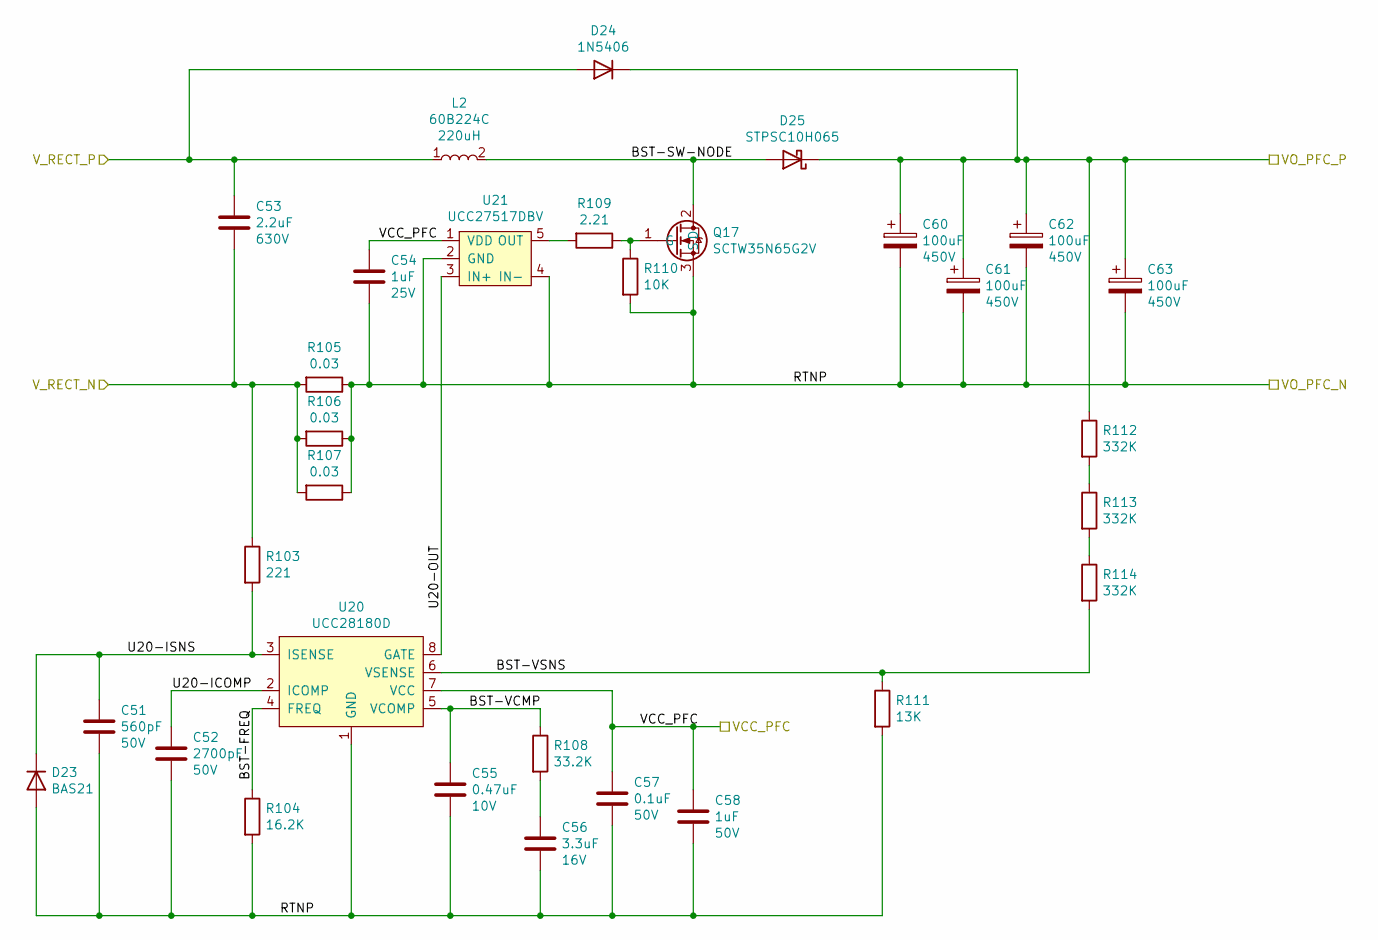
[picture p4: schematic PFC.sch, PFC PowerTrain]

Parts:
C51: C1608C0G1H561J; C_0603_1608Metric_Pad1.05x0.95mm_HandSolder; Voltage 50V
C52: C1608C0G1H272J; C_0603_1608Metric_Pad1.05x0.95mm_HandSolder; Voltage 50V
C53: ECW-FA2J225J; C_Rect_L26.0mm_W16.3mm_P22.50mm; Voltage 630V
C54: C1608X7R1E105K080AB; C_0603_1608Metric_Pad1.05x0.95mm_HandSolder; Voltage 25V
C55: C1608X5R1A474K; C_0603_1608Metric_Pad1.05x0.95mm_HandSolder; Voltage 10V
C56: CL31B335KOHNNNE; C_1206_3216Metric_Pad1.42x1.75mm_HandSolder; Voltage 16V
C57: CC0805KRX7R9BB104; C_0805_2012Metric_Pad1.15x1.40mm_HandSolder; Voltage 50V
C58: CL21B105KBFNNNE; C_0805_2012Metric_Pad1.15x1.40mm_HandSolder; Voltage 50V
C60, C61, C62, C63: EKXG451ELL101MM40S; CP_Radial_D18.0mm_P7.50mm; Voltage 450V
D23: BAS21; SOT-23
D24: 1N5406; D_DO-201AD_P15.24mm_Horizontal
D25: STPSC10H065; TO-220-2_Vertical
L2: 60B224C; L_Murata_6000B_Handsoldering
Q17: SCTW35N65G2V; TO-247-3_Vertical
R103: CRCW0603221RFKEA; R_0603_1608Metric_Pad1.05x0.95mm_HandSolder
R104: CRCW060316K2FKEA; R_0603_1608Metric_Pad1.05x0.95mm_HandSolder
R105, R106, R107: CSRN2512FK30L0; R_2512_6332Metric_Pad1.52x3.35mm_HandSolder
R108: CRCW060333K2FKEA; R_0603_1608Metric_Pad1.05x0.95mm_HandSolder
R109: CRCW08052R21FKEA; R_0805_2012Metric_Pad1.15x1.40mm_HandSolder
R110: CRCW060310K0FKEA; R_0603_1608Metric_Pad1.05x0.95mm_HandSolder
R111: CRCW060313K0FKEA; R_0603_1608Metric_Pad1.05x0.95mm_HandSolder
R112, R113, R114: CRCW1206332KFKEA; R_1206_3216Metric_Pad1.42x1.75mm_HandSolder
U20: UCC28180D; SOIC-8_3.9x4.9mm_P1.27mm
U21: UCC27517DBV; SOT-23-5_HandSoldering

Connections:
/PFC/BST-FREQ: R104.1, U20.4 (FREQ)
/PFC/BST-SW-NODE: D25.2 (A), L2.2, Q17.2 (D)
/PFC/BST-VCMP: C55.1, R108.1, U20.5 (VCOMP)
/PFC/BST-VSNS: R111.1, R114.2, U20.6 (VSENSE)
/PFC/U20-ICOMP: C52.1, U20.2 (ICOMP)
/PFC/U20-ISNS: C51.1, D23.3 (K), R103.2, U20.3 (ISENSE)
/PFC/U20-OUT: U20.8 (GATE), U21.3 (IN+)
/PFC/V_RECT_N: C53.2, R103.1, R105.2, R106.2, R107.2; also elsewhere on the board
/PFC/V_RECT_P: C53.1, D24.2 (A), L2.1; also elsewhere on the board
/PSFB/VINP: C60.1, C61.1, C62.1, C63.1, D24.1 (K), D25.1 (K), R112.1; also elsewhere on the board
/RTNP: C51.2, C52.2, C54.2, C55.2, C56.2, C57.2, C58.2, C60.2, C61.2, C62.2, C63.2, D23.1 (A), Q17.3 (S), R104.2, R105.1, R106.1, R107.1, R110.2, R111.2, U20.1 (GND), U21.2 (GND), U21.4 (IN-); also elsewhere on the board
/VCC_PFC: C54.1, C57.1, C58.1, U20.7 (VCC), U21.1 (VDD); also elsewhere on the board
unnamed: C56.1, R108.2
unnamed: Q17.1 (G), R109.1, R110.1
unnamed: R109.2, U21.5 (OUT)
unnamed: R112.2, R113.1
unnamed: R113.2, R114.1

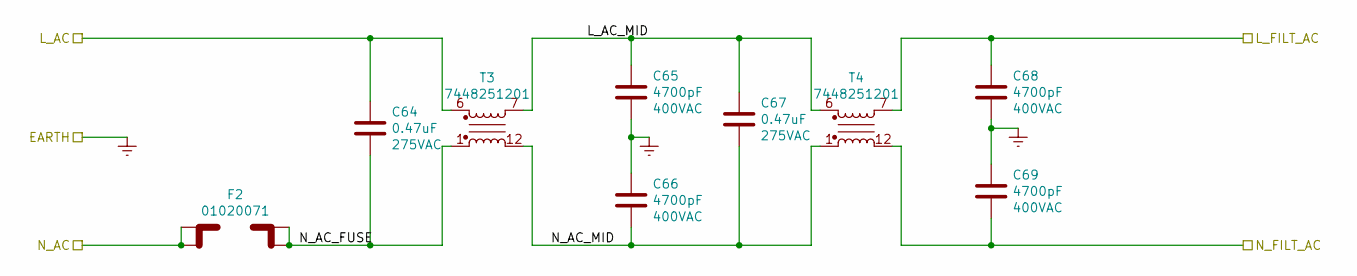
[picture p5: schematic Inputfilter.sch, Input Filter]

Parts:
C64, C67: ECQ-U2A474ML; C_Rect_L26.5mm_W8.5mm_P22.50mm_MKS4; Voltage 275VAC
C65, C66, C68, C69: C961U472MYWDBA7317; C_Disc_D14.5mm_W5.0mm_P10.00mm; Voltage 400VAC
F2: 01020071; Fuseholder_Littelfuse_0.25inD_1.25inL
T3, T4: 7448251201; Choke_Wurth_7448251201

Connections:
/Inputfilter/L_AC: C64.1, T3.6; also elsewhere on the board
/Inputfilter/L_AC_MID: C65.1, C67.1, T3.7, T4.6
/Inputfilter/L_FILT_AC: C68.1, T4.7; also elsewhere on the board
/Inputfilter/N_AC: F2.1, F2.2; also elsewhere on the board
/Inputfilter/N_AC_FUSE: C64.2, F2.3, F2.4, T3.1
/Inputfilter/N_AC_MID: C66.2, C67.2, T3.12, T4.1
/Inputfilter/N_FILT_AC: C69.2, T4.12; also elsewhere on the board
Earth: C65.2, C66.1, C68.2, C69.1; also elsewhere on the board
