phamhuuhuyhoang/bench-pwr-rig/board/bench_pwr_rig/bench_pwr_rig.kicad_pcb

## KiCad design board/bench_pwr_rig/bench_pwr_rig.kicad_pcb (continued)

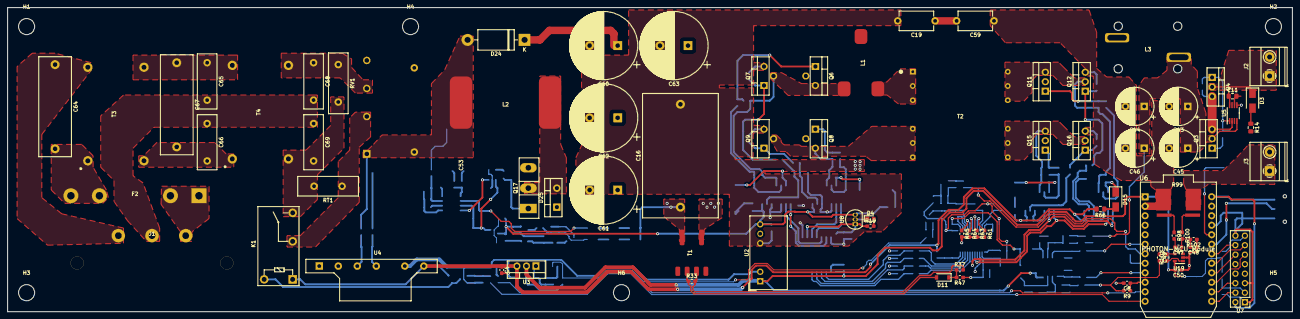
[picture p6: board bench_pwr_rig.kicad_pcb from above]

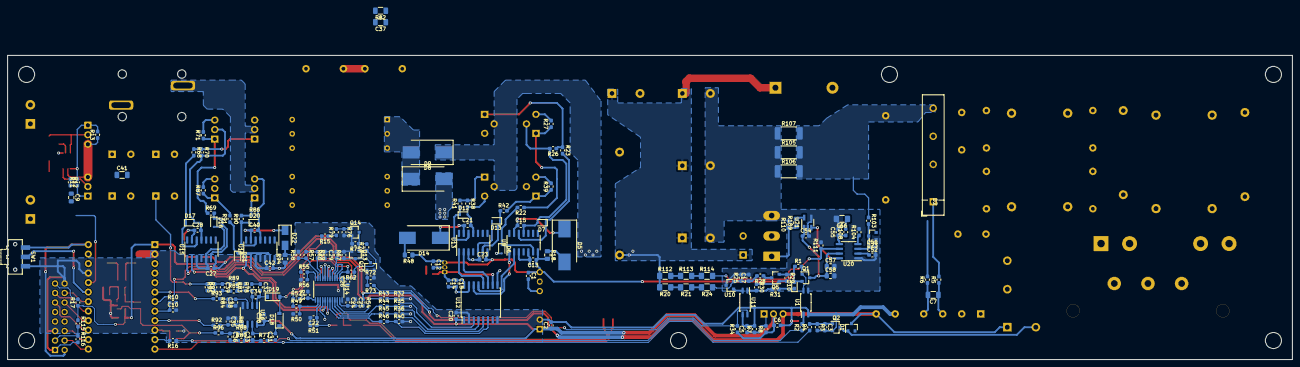
[picture p7: board bench_pwr_rig.kicad_pcb from below]

Board: 2 copper layers, 343.4 x 81.3 mm, 268 parts (182 on the bottom side), 160 nets.
