phamhuuhuyhoang/bench-pwr-rig/(commit log)

2020-10-17 added kicad project
    initial creation of kicad project
    added schematic
    added board file
    [bench_pwr_rig.kicad_pcb, bench_pwr_rig.sch, buck_boost.sch]
2020-10-18 Use photon
    Updated schematic to use particle photon device for 3.3V interface to existing NHD-0208AZ-RN-YBW-3V in stock
    [bench_pwr_rig.sch, buck_boost.sch]
2020-10-23 Updated powertrain schematic
    Changed powertrain to PSFB
    Updated schematic
    Added new symbols
    [PSFB.sch, bench_pwr_rig.sch, bom.xlsx, buck_boost.sch]
2020-10-23 Delete buck_boost.sch
    Delete unused schematic
    [buck_boost.sch]
2020-10-28 Schematic Update
    Added Input Filter and PFC sections
    Added capacitor, resistor, and protection parts library
    Started a jupyter notebook for PFC section
    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
    [ACinputfilter.sch, Inputfilter.sch, PFC.sch, PSFB.sch, bench_pwr_rig.sch, bom.xlsx]
2020-11-07 schematic and layout updates
    Finalized schematic for rev 0.1. Anticipate additional component values update through analysis. Moving to layout
    [Inputfilter.sch, PFC.sch, PSFB.sch, bench_pwr_rig.kicad_pcb, bench_pwr_rig.sch]
2020-11-18 Updated layout
    Added output screw terminal
    Added mounting screws M4
    Changed primary ground to secondary ground plane coupling capacitor to radial disc type with safety rating X1, Y1
    Continued layout
    [Inputfilter.sch, PFC.sch, PSFB.sch, bench_pwr_rig.kicad_pcb, bench_pwr_rig.sch]
